FRCTeam3044/PublicFileShare/README.md

#Team 3044 File Share
Team 3044's Public file share for parts used on the robot this year, As well as premanufactured parts
