FRCTeam3044/PublicFileShare/flowcharts/readme.md

#Flow Charts
in ordre to share flow charts
