FRCTeam3044/PublicFileShare/BreakoutBoards/readme.md

#Breakout Boards
This section contains all files for breakout boards used on the Team3044 robot in 2016
