FRCTeam3044/PublicFileShare/3dParts/readme.md

#3d Printed Parts
Contains information and files for parts to be printed
