FRCTeam3044/PublicFileShare/3dParts/Spacers/217-3257-STEP.stl

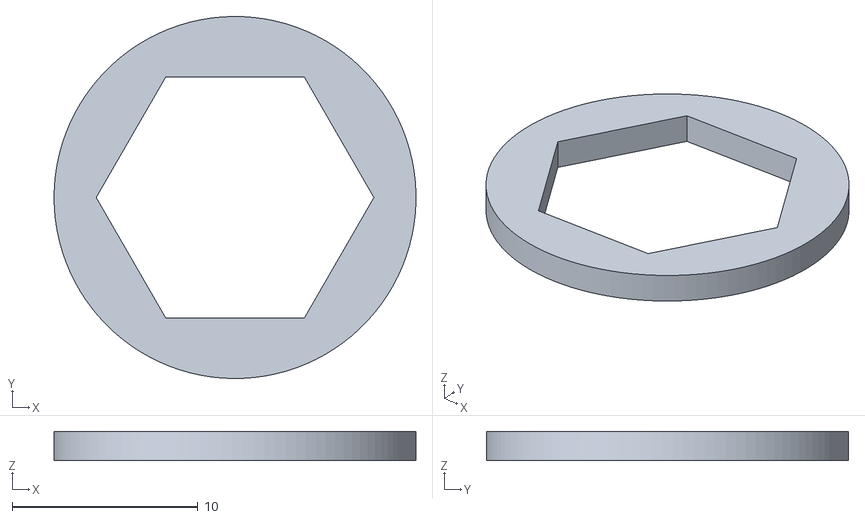
[picture p9: CAD file, 2016-03-08]
3dParts/Spacers/217-3257-STEP.stl
19.5 x 19.5 x 1.59
