FRCTeam3044/PublicFileShare/3dParts/Spacers/217-2758.stl

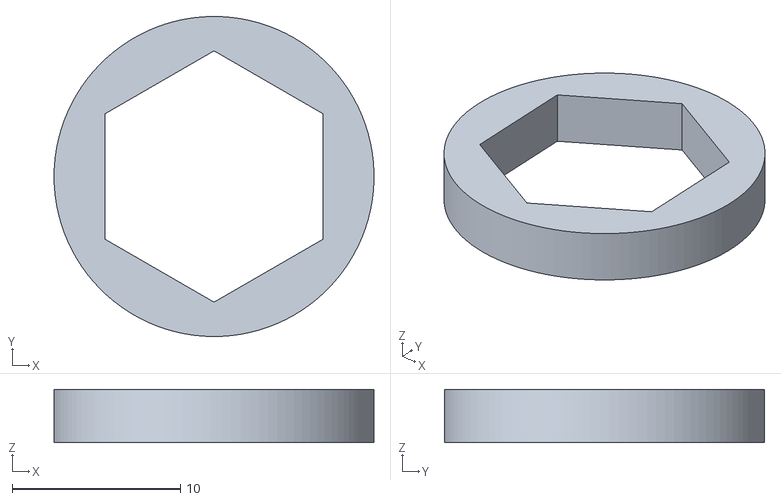
[picture p10: CAD file, 2016-03-08]
3dParts/Spacers/217-2758.stl
19.0 x 19.0 x 3.17
