FRCTeam3044/PublicFileShare/3dParts/Spacers/217-3259-STEP.stl

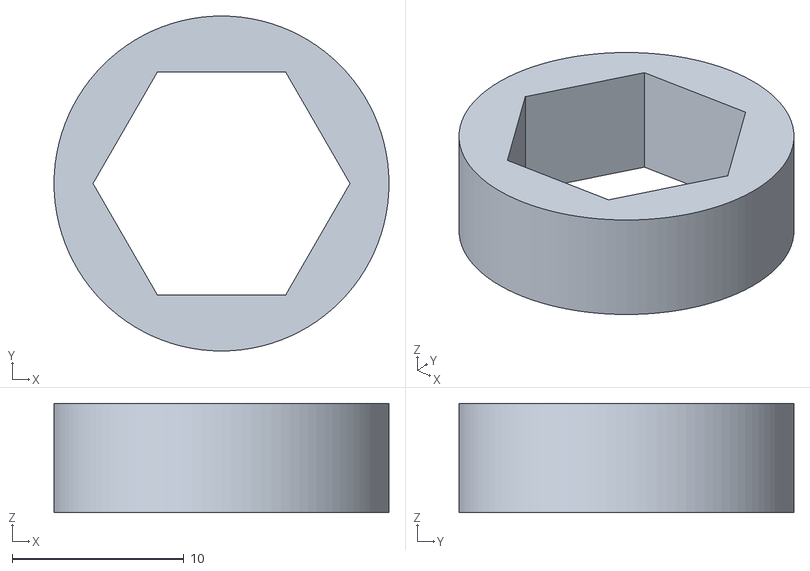
[picture p11: CAD file, 2016-03-08]
3dParts/Spacers/217-3259-STEP.stl
19.5 x 19.5 x 6.35
