FRCTeam3044/PublicFileShare/3dParts/HowTo.md

#How to print 3d parts Team 3044
```
1)If cubify v3.40 software is not installed, download from here: https://drive.google.com/file/d/0B3StMQBAS-3ANVhVTHNzZDVZaTA/view?usp=sharing
2)Connect to "coolcube" wifi network
3)Launch Cubifyv3.40 Software
3)Click the printer button in the upper left, and select cool cube ekocycle printer
4)Click "Add" button and select "From File"
5)Add the file to your "Shelf" Rename if prompted
6)Rearrange the part if necessary so it lays flat
7)Scale to 104%
8)Select Build and configure settings
9)Click Print
10)Follow Prompts to add glue, etc

Pictures coming soon, questions? joeylyon1@gmail.com
```
