FRCTeam3044/PublicFileShare/(list of files, drawings)

Other design files:
BreakoutBoards/TalonSRX_Breakout.pcb
